mharisirfan/Robian2019-MySumoRobot/b.jpeg

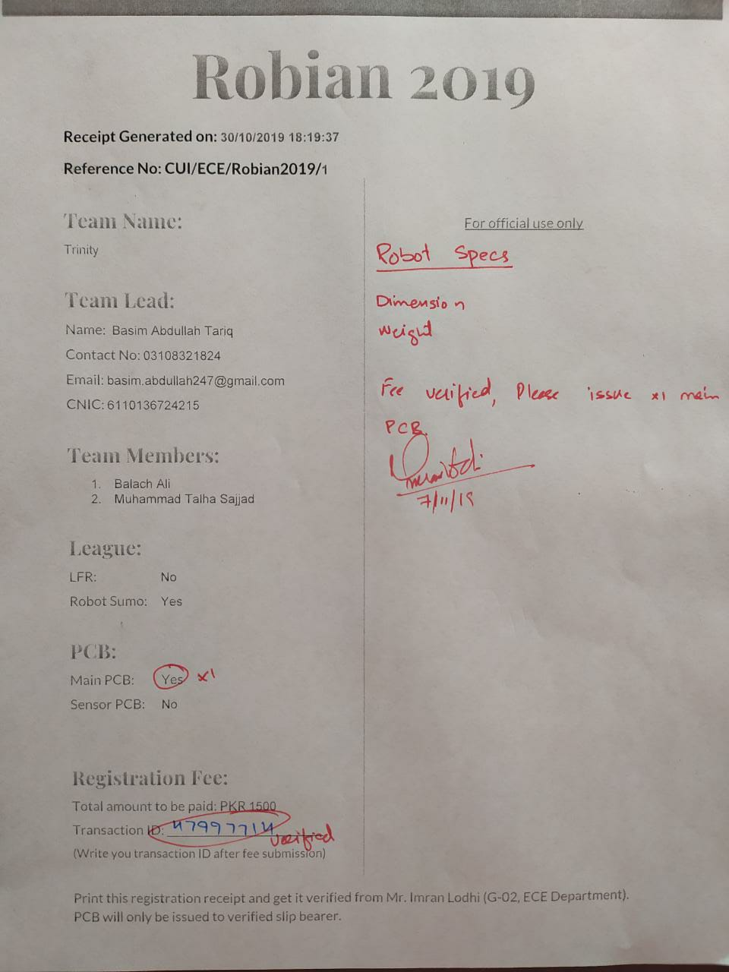
b.jpeg
