mharisirfan/Robian2019-MySumoRobot/a.jpeg

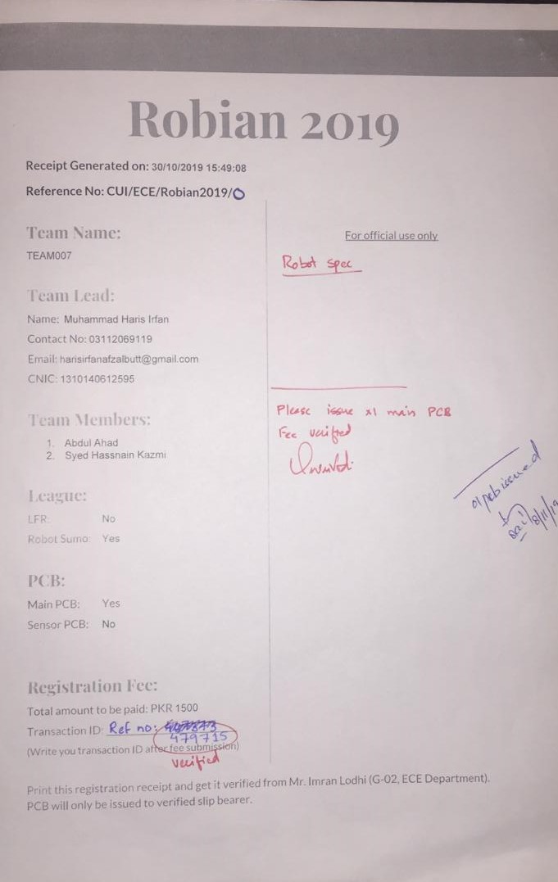
a.jpeg
