mharisirfan/Robian2019-MySumoRobot/Data/Robot LRF Sensor Module v1.1 Documents/SesnsorBoardTop.png

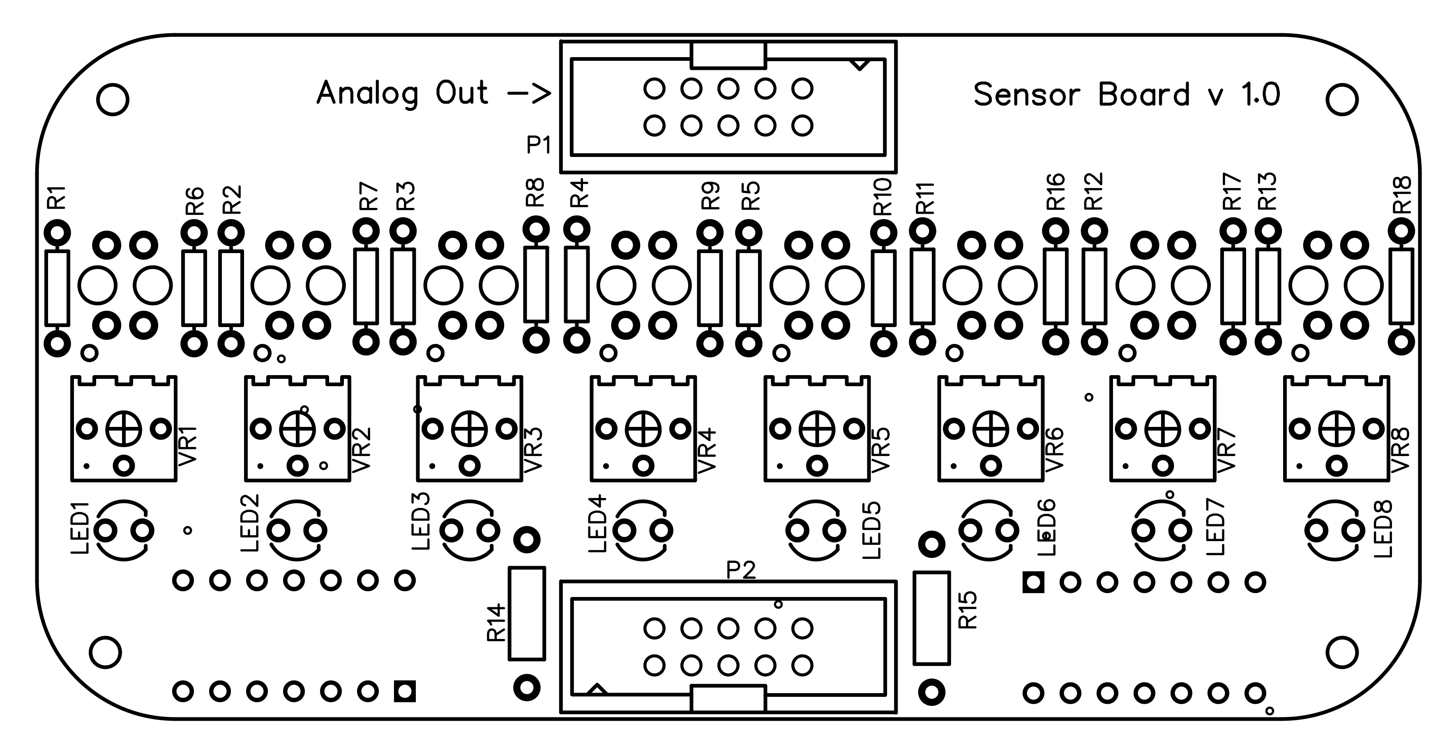
Data/Robot LRF Sensor Module v1.1 Documents/SesnsorBoardTop.png
