mharisirfan/Robian2019-MySumoRobot/Data/Codes/robotSUMO/anothertry/anothertry.ino

#include<SoftwareSerial.h>

#define IN1 5
#define IN2 6
#define IN3 7
#define IN4 8
//#define EN1 9
//#define EN2 10

SoftwareSerial mySerial(1, 0); // RX, TX

String data;
int btVal;

void setup() 
{  
  //Serial.begin(115200);
  pinMode(IN1, OUTPUT);
  pinMode(IN2, OUTPUT);
  pinMode(IN3, OUTPUT);
  pinMode(IN4, OUTPUT);
  //pinMode(EN1, OUTPUT);
  //pinMode(EN2, OUTPUT);
  digitalWrite(IN1, LOW);
  digitalWrite(IN2, LOW);
  digitalWrite(IN3, LOW);
  digitalWrite(IN4, LOW);
  //analogWrite(EN1,63);
  //analogWrite(EN2,63);
  mySerial.begin(9600);
}

void loop()
{
 while (mySerial.available())
 {  
  {  
      data = mySerial.readStringUntil('\n');
      //Serial.print(str);             
  } 
    
    btVal = (data.toInt());
    //Serial.print("BlueTooth Value ");
    //Serial.println(btVal);    



  switch (btVal) 
   {
      case 1:                                
        //Serial.println("Forward");
        forward();
        break;

      case 2:                 
       //Serial.println("Reverse");
        reverse();
        break;

      case 3:         
       //Serial.println("Left");
        left();
        break;
        
      case 4:                     
        //Serial.println("Right");
        right();
        break;
        
      case 5:                                            
        //Serial.println("Stop");
        stoprobot();
        break;      

  }

 } 
 
                                                              
   if (mySerial.available() < 0)                              
    {
     //Serial.println("No Bluetooth Data ");          
    }
  
}

void forward()
{
  digitalWrite(IN1, HIGH);
  digitalWrite(IN2, LOW);
  digitalWrite(IN3, HIGH);
  digitalWrite(IN4, LOW);
}

void reverse()
{
  digitalWrite(IN1, LOW);
  digitalWrite(IN2, HIGH);
  digitalWrite(IN3, LOW);
  digitalWrite(IN4, HIGH);
}

void left()
{
  digitalWrite(IN1, LOW);
  digitalWrite(IN2, LOW);
  digitalWrite(IN3, HIGH);
  digitalWrite(IN4, LOW);
}

void right()
{
  digitalWrite(IN1, HIGH);
  digitalWrite(IN2, LOW);
  digitalWrite(IN3, LOW);
  digitalWrite(IN4, LOW);
}

void stoprobot()
{
  digitalWrite(IN1, LOW);
  digitalWrite(IN2, LOW);
  digitalWrite(IN3, LOW);
  digitalWrite(IN4, LOW);
}
