mharisirfan/Robian2019-MySumoRobot/Data/Codes/MATCHDAYFINAL/MATCHDAYFINAL.ino

                                                                                  zR |
ˆ  (   
   àÏÿÿ
   AƒC@b4C@L<C@Ô<       H   ÄÐÿÿc   AƒC0E
AÃF
   l   Òÿÿ    C    €   
Òÿÿ    C    ”   (Òÿÿ          ¨   $Òÿÿ              zR |
ˆ  
   
   ˆÔÿÿC    C U
H
`   8   <   ¸Ôÿÿ†    A†A
ƒC d

FÃAÆC
k

FÃAÆC
     x   
Õÿÿ              zR |
ˆ  
   
   ðÔÿÿÜ    ]ƒ¤ÃBƒ       zR |
ˆ     
   ˜Õÿÿ              zR |
ˆ     
   |ÕÿÿR    AƒC0   <   8   ÀÕÿÿ   C`DƒY†F‡F…ETC`t
ÅÇÆÃH
iPC`RPC`   $   x   ÖÿÿÔ   l0Oƒ†‡ã
ÇÆÃB
          zR |
ˆ     
   0Øÿÿ,    N\     4   HØÿÿI    AƒC m
AÃA
    X   tØÿÿ
              zR |
ˆ  8   
   hØÿÿ`    A†A
ƒC L
I P
C j
C C
AÃAÆ 4   X   ŒØÿÿŒ    C I†FƒQ
ÆÃA
s
Q L
E K
ÃÆA
  <      äØÿÿ    AƒC P
CÃA
L
I n
C C
CÃA
Z
C  (   Ð   4Ùÿÿ˜    C X
E
i
C _
E
\
C                                                                                                 <`          ,c  ¼`  p`          „c  ð`                      <a  Ta  la  za  Ša  ža  °a  Ìa  äa  b  b  "b      2b  Bb  Rb  `b  rb  |b  „b  Žb  šb  ¢b  ¬b  ¶b  ¾b  Èb  Òb  Üb  æb  ðb      <a  Ta  la  za  Ša  ža  °a  Ìa  äa  b  b  "b      2b  Bb  Rb  `b  rb  |b  „b  Žb  šb  ¢b  ¬b  ¶b  ¾b  Èb  Òb  Üb  æb  ðb      Ï DeleteCriticalSection ì EnterCriticalSection  ExitProcess þGetLastError  GetModuleHandleA  AGetProcAddress  ÞInitializeCriticalSection .LeaveCriticalSection  tSetUnhandledExceptionFilter •TlsGetValue ½VirtualProtect  ¿VirtualQuery  7 __getmainargs M __p__environ  O __p__fmode  c __set_app_type  “ _cexit  

<  t¬
@    H I<GH  t¨  
¶@ •   i <  t¤
Ã@ f   j <  t    
<  n  
n  
n   sizetype <  
C  ‹  
